krikun98/Willis/(commit log)

2024-08-29 Willis V0.1 WIP for external review
    [willis.kicad_sch]
2024-08-31 Add 3D model for E73, more routing fixes
    [willis.kicad_sch]
2024-08-31 Add TC2030 SWD footprint
    [willis.kicad_sch]
2024-08-31 Silkscreen clarifications
2024-08-31 More silkscreen text
2024-10-10 V0.1: first manufactured revision
    [willis.kicad_sch]
2024-10-11 PCB V0.2
    - Move components out of JST connector's way
    - Add labels for reset/soft_off
    - Add CERN-OHL-P v2 license statement/files and Open Hardware logo
    - Silkscreen adjustments
    - Add IBOM
    - Bump PCB/schematic versions
    [willis.kicad_sch]
2024-10-11 Add V0.2 PCB pictures/prototype photo
2024-11-24 V0.3: fixes for DCCH inductor circuit
    [willis.kicad_sch]
